IrisYzh/SnapChef/Ideation/Fridge Ingredient Recognition Device.docx

Fridge Ingredient Recognition Device

1. Project vision

FridgeLens is a magnet-mounted, battery-powered device that attaches to a refrigerator door. When the user presses a button, the onboard camera captures the fridge interior and a TensorFlow Lite model running on the XIAO ESP32S3 classifies the ingredients present. An OLED screen then suggests a recipe based on what is currently available and flags any ingredients that are close to expiring. The device works fully offline with no external data transmission.

It is designed for people who cook at home regularly but often struggle to decide what to make, or forget about ingredients that sit in the fridge too long and go to waste. FridgeLens bridges the gap between "I have stuff in the fridge" and "I know what to cook tonight."

2. Design target

- Classification accuracy: at least 85% across all 5 classes on a held-out test set
- Inference latency: under 2 seconds from button press to OLED display
- Battery life: at least 8 hours of standby with 50 active captures/day on a 1000 mAh LiPo
- Model size: under 1 MB to fit within the ESP32S3 flash budget

3. Resource constraint

The ESP32S3 provides 8 MB flash and 512 KB SRAM. The model binary is budgeted at 1 MB; runtime inference is capped at 200 KB SRAM to leave room for the image buffer and OLED driver. Camera input will be downsampled to 96x96 grayscale. The camera module powers down between captures to meet the battery target.

4. Trade-off hypothesis

The main trade-off is model size vs. accuracy. A MobileNetV2 backbone quantized to INT8 at 96x96 input is expected to meet the accuracy target while staying within the memory budget. Three operating points will be tested, 96x96 INT8, 128x128 INT8, and 96x96 FP32, and results will be plotted to identify the best trade-off. The prediction is that INT8 quantization costs less than 3% accuracy while reducing model size by roughly 4x.

5. Dataset plan

5 classes reflecting common everyday fridge ingredients: eggs, carrots, leafy greens, tofu, and condiment bottles. 150 images per class will be self-captured inside a real fridge under varied lighting and partial occlusion, then augmented to roughly 600 per class. A public food image dataset will supplement self-collected data. Split: 70% train / 10% validation / 20% test. The test set is held out until final evaluation. Class balance will be verified before training.

6. Timeline

Week | Milestone
1–2 | Hardware setup; data collection begins
3 | Dataset complete; augmentation applied
4 | Baseline model trained (224x224 FP32)
5 | TFLite INT8 conversion; first on-device inference
6 | Full pipeline integrated (button, camera, inference, OLED)
7 | Recipe matching and expiry reminder logic added
8 | Systematic evaluation: accuracy, latency, battery
9 | Enclosure built; UI polished
10 | Final report and demo submission

7. Risks

- Fridge lighting variability. Low or inconsistent light is the most likely failure mode. Mitigation: collect training data under low-light conditions and add a small fill LED to the enclosure.
- RAM overflow at inference time. If the model exceeds the memory budget, fall back to MobileNetV1 or reduce input to 64x64. Memory profiling will happen in Week 5 before full hardware integration.
