IrisYzh/SnapChef/image/receipt.png

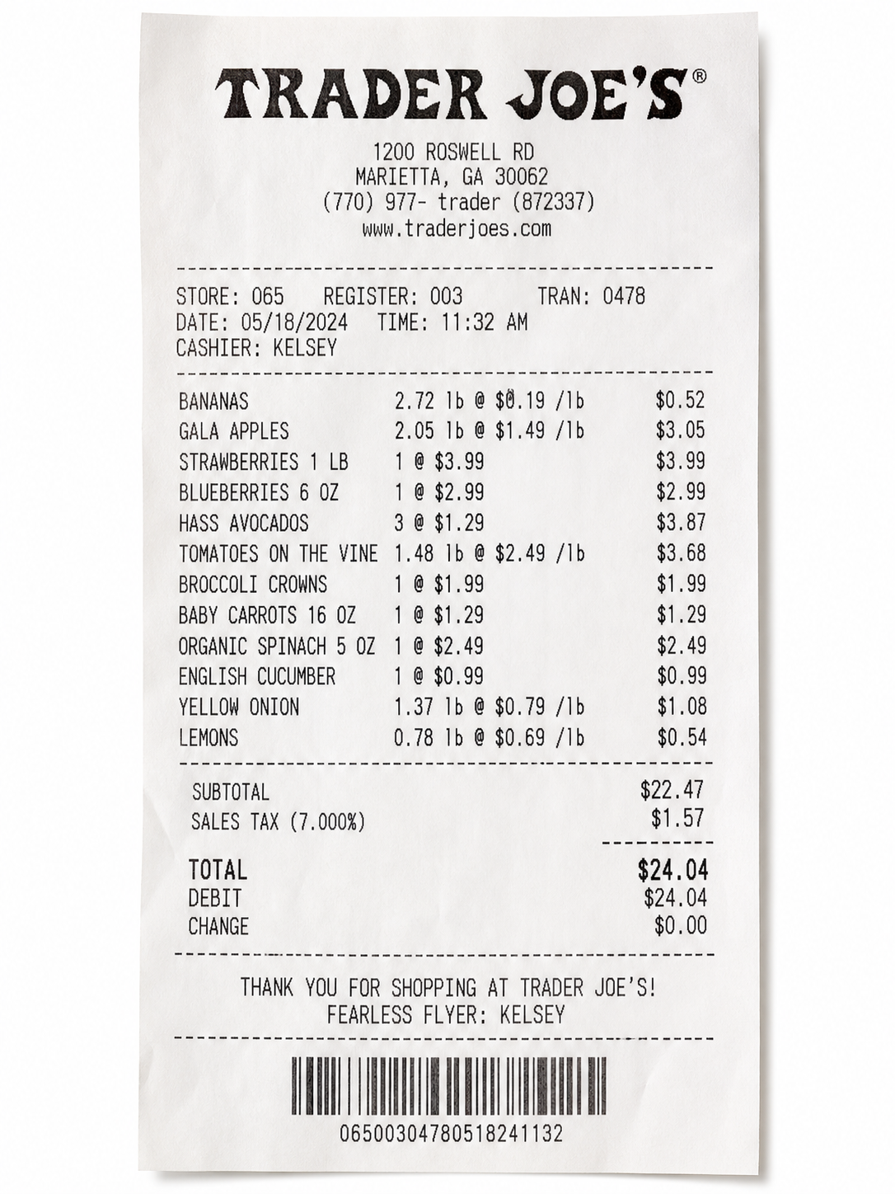
image/receipt.png
