IrisYzh/SnapChef/image/Workflow.png

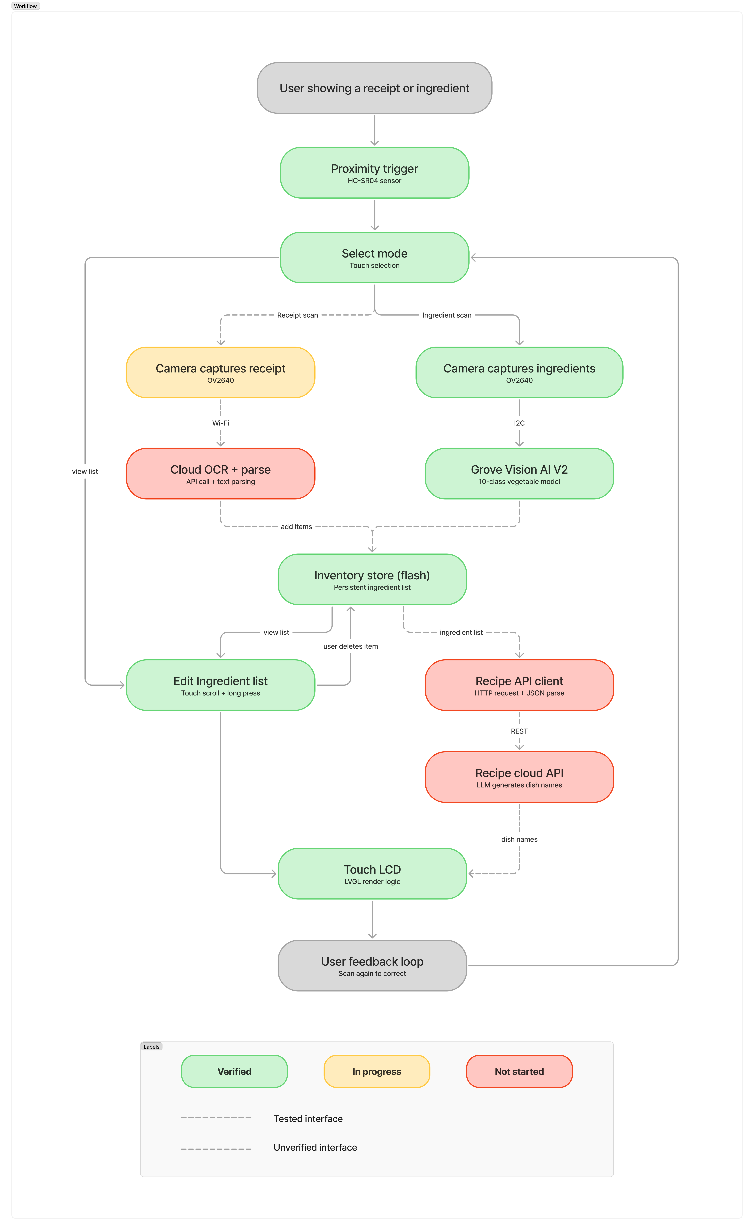
image/Workflow.png
