IrisYzh/SnapChef/HWSW Team Final Enclosure.step

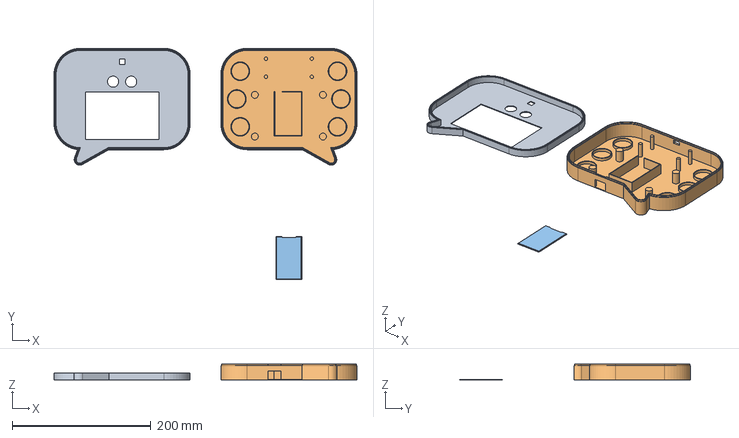
[picture p44: CAD file, 2026-06-10]
HWSW Team Final Enclosure.step
436.0 x 333.0 x 23.0 mm
