IrisYzh/SnapChef/src/main/main.ino

/*
 * SnapChef — Main controller (XIAO ESP32S3 Sense)
 *
 * Hosts the camera, HC-SR04 ultrasonic, WiFi, and an ESP-NOW peer link to
 * the display device (Waveshare 4.3" Touch LCD). This firmware is "headless"
 * — all UI lives on the display board, which talks to us over ESP-NOW.
 *
 * Capabilities exposed over ESP-NOW (tag 'E' / 'D' events, tag 'C' commands):
 *   1. Idle proximity wake — emits {"evt":"proximity_wake"} when an object
 *      is detected within ~10 cm of the HC-SR04.
 *   2. Veggie classification — on {"cmd":"start_veggie_scan"} runs the
 *      MobileNetV2 INT8 classifier (128x128, V4 weights) lifted from esp32_deploy_V7.
 *      Locks on >=80% top-1 confidence over 3 consecutive frames; gives up
 *      after 20 s.
 *   3. Receipt scan — on {"cmd":"capture_receipt"} switches the camera to
 *      UXGA, captures a single JPEG, POSTs it to /receipts/analyze, and
 *      streams the parsed items back as individual 'E' events.
 *   4. Recipe lookup — on {"cmd":"get_recipe","ingredients":[...]} returns a
 *      hard-coded mock recipe (Carrot/Eggplant/generic) — backend not built.
 *
 * Wiring (XIAO ESP32S3 Sense):
 *   HC-SR04: VCC -> 5V, GND -> GND, TRIG -> GPIO2, ECHO -> GPIO1
 *   Camera : FFC connector (OV2640 / OV3660)
 *
 * Arduino IDE setup:
 *   - Board: "XIAO_ESP32S3"
 *   - PSRAM: "OPI PSRAM"
 *   - Partition scheme: "Huge APP (3MB No OTA/1MB SPIFFS)"
 *
 * Required libraries:
 *   - TensorFlowLite_ESP32
 *   - WiFi / WiFiClientSecure / HTTPClient / esp_now (built in)
 */

#include <Arduino.h>
#include <vector>

#include <esp_camera.h>
#include <esp_heap_caps.h>
#include <mbedtls/base64.h>

#include <WiFi.h>
#include <WiFiClientSecure.h>
#include <HTTPClient.h>
#include <WebServer.h>

#include <esp_now.h>
#include <esp_wifi.h>
#include <time.h>

#include "tensorflow/lite/micro/micro_interpreter.h"
#include "tensorflow/lite/micro/micro_mutable_op_resolver.h"
#include "tensorflow/lite/schema/schema_generated.h"

#include "model_data.h"
#include "labels.h"
#include "snapchef_espnow.h"

// ============================================================================
//                                  CONFIG
// ============================================================================

// --- WiFi (UW MPSK; same credentials as receipt_read.ino) ---
static const char* WIFI_SSID = "UW MPSK";
static const char* WIFI_PASS = "5gwXiwWSng3EXHq5";

// --- Backend ---
static const char* API_URL     = "https://snapchef-backend-production.up.railway.app/receipts/analyze";
// Produce recognition uses the Claude-Vision endpoint (recognize-llm) rather
// than the Baidu one (recognize): same request/response shape, but far more
// robust on hand-held / plastic / poorly-framed shots where Baidu returns
// Uncertain. Request/response contract is identical, so the parsing below is
// unchanged (raw_name is always null on this endpoint).
static const char* PRODUCE_URL = "https://snapchef-backend-production.up.railway.app/produce/recognize-llm";
static const char* HEALTHZ_URL = "https://snapchef-backend-production.up.railway.app/healthz";
// Recipe endpoints (Claude-backed on the backend; change BASE_URL if you move
// these to a different host). Same X-API-Key as receipts.
static const char* RECIPES_LIST_URL  = "https://snapchef-backend-production.up.railway.app/recipes/list";
static const char* RECIPES_STEPS_URL = "https://snapchef-backend-production.up.railway.app/recipes/steps";
static const char* API_KEY     = "snapchefasdfghjkl123456789";
static const char* BOUNDARY    = "----snapchef32boundary";
static const int   HTTP_TIMEOUT_MS = 20000;
static const int   RECIPE_HTTP_TIMEOUT_MS = 30000;   // LLM generation can be slow

// --- HC-SR04 ---
static const int   TRIG_PIN     = 2;
static const int   ECHO_PIN     = 1;
static const float DETECT_CM    = 10.0f;
static const unsigned long PROXIMITY_INTERVAL_MS = 200;
static const unsigned long PROXIMITY_COOLDOWN_MS = 3000;

// --- Veggie classifier (mirrors esp32_deploy_V6.ino) ---
static const unsigned long INFERENCE_INTERVAL_MS = 500;
// On-device scan window. If nothing locks in this time we fall back to the
// cloud /produce/recognize endpoint, which has its own HTTP_TIMEOUT_MS budget.
static const unsigned long VEGGIE_LOCAL_TIMEOUT_MS = 5000;
static const int  IMG_W = 128, IMG_H = 128, IMG_C = 3;     // V4 model: 128x128
static const int  TENSOR_ARENA_SIZE = 700 * 1024;          // ~(128/96)^2 of V3's 512KB
static const float CONF_LOCK = 0.90f;
static const int   LOCK_STREAK_NEEDED    = 3;
static const int   RELEASE_STREAK_NEEDED = 3;
// Highest-fidelity JPEG quality (lower = better) used for both full-res
// captures — receipt OCR and cloud produce recognition. The camera DMA/JPEG
// buffer is sized at init for this value, so the runtime up-shift to it never
// overflows (see initCamera + captureJpegUXGA). Don't push below ~6 without
// re-checking PSRAM headroom and the backend's ~3 MB raw-image cap.
static const int   CAPTURE_JPEG_QUALITY = 6;

// --- Camera pins (XIAO ESP32S3 Sense FFC) ---
#define PWDN_GPIO_NUM   -1
#define RESET_GPIO_NUM  -1
#define XCLK_GPIO_NUM   10
#define SIOD_GPIO_NUM   40
#define SIOC_GPIO_NUM   39
#define Y9_GPIO_NUM     48
#define Y8_GPIO_NUM     11
#define Y7_GPIO_NUM     12
#define Y6_GPIO_NUM     14
#define Y5_GPIO_NUM     16
#define Y4_GPIO_NUM     18
#define Y3_GPIO_NUM     17
#define Y2_GPIO_NUM     15
#define VSYNC_GPIO_NUM  38
#define HREF_GPIO_NUM   47
#define PCLK_GPIO_NUM   13

// QVGA RGB888 buffer used by the veggie pipeline.
static const int CAPTURE_W = 320;
static const int CAPTURE_H = 240;

// ============================================================================
//                              GLOBAL STATE
// ============================================================================

enum MainState {
    STATE_IDLE,
    STATE_VEGGIE_SCAN,
    STATE_RECEIPT_CAPTURE,
    STATE_RECEIPT_UPLOAD,
    STATE_RECIPE,
};

static volatile MainState gState = STATE_IDLE;
static volatile bool gCancelRequested = false;
static String  gPendingPurpose = "in";           // for veggie scan
static String  gPendingIngredientsJson = "[]";   // for recipe
static String  gPendingTrigger = "";             // for recipe list (just-removed item)
static String  gPendingDish    = "";             // for recipe steps (chosen dish)

// --- TFLM ---
static uint8_t* tensor_arena = nullptr;
static uint8_t* rgb888_buf   = nullptr;
static const tflite::Model*       tfl_model     = nullptr;
static tflite::MicroInterpreter*  interpreter   = nullptr;
static TfLiteTensor*              input_tensor  = nullptr;
static TfLiteTensor*              output_tensor = nullptr;
static float   input_scale = 0, output_scale = 0;
static int32_t input_zero_point = 0, output_zero_point = 0;
static int     unknown_class_idx = -1;

// --- Veggie smoothing ---
static int   current_display_idx  = -1;
static float current_display_conf = 0.0f;
static int   lock_candidate_idx   = -1;
static int   lock_streak          = 0;
static int   release_streak       = 0;

// --- ESP-NOW link to the display ---
static const uint8_t BROADCAST_MAC[6] = { 0xFF,0xFF,0xFF,0xFF,0xFF,0xFF };
static uint8_t       gPeerMac[6]      = {0};
static volatile bool gPeerLinked      = false;
static volatile bool gPeerJustLinked  = false;   // set on HELLO, drained in loop()

// --- Pending commands queue (filled in ESP-NOW recv callback, drained in loop()) ---
static volatile bool gCmdPending = false;
static String gPendingCmd;

// --- DEBUG: last captured receipt JPEG, served over HTTP for browser preview ---
static WebServer  gDebugServer(80);
static uint8_t*   gLastJpeg    = nullptr;
static size_t     gLastJpegLen = 0;
static uint32_t   gLastJpegSeq = 0;

// ============================================================================
//                              FORWARD DECLS
// ============================================================================

static bool initCamera();
static bool initModel();
static bool captureAndPreprocess(int8_t* dst);
static uint8_t* captureJpegUXGA(int jpegQuality, size_t& outLen);
static void resetSmoothing();
static void runVeggieScan();
static bool runCloudProduceFallback(const String& purpose);
static void runReceiptCapture();
static void runRecipe();
static void runRecipeList();
static void runRecipeSteps();
static void sendEvent(const String& json);
static void sendData(const String& payload);

// ============================================================================
//                               CAMERA
// ============================================================================

static bool initCamera() {
    camera_config_t config = {};
    config.ledc_channel = LEDC_CHANNEL_0;
    config.ledc_timer   = LEDC_TIMER_0;
    config.pin_d0       = Y2_GPIO_NUM;
    config.pin_d1       = Y3_GPIO_NUM;
    config.pin_d2       = Y4_GPIO_NUM;
    config.pin_d3       = Y5_GPIO_NUM;
    config.pin_d4       = Y6_GPIO_NUM;
    config.pin_d5       = Y7_GPIO_NUM;
    config.pin_d6       = Y8_GPIO_NUM;
    config.pin_d7       = Y9_GPIO_NUM;
    config.pin_xclk     = XCLK_GPIO_NUM;
    config.pin_pclk     = PCLK_GPIO_NUM;
    config.pin_vsync    = VSYNC_GPIO_NUM;
    config.pin_href     = HREF_GPIO_NUM;
    config.pin_sccb_sda = SIOD_GPIO_NUM;
    config.pin_sccb_scl = SIOC_GPIO_NUM;
    config.pin_pwdn     = PWDN_GPIO_NUM;
    config.pin_reset    = RESET_GPIO_NUM;
    config.xclk_freq_hz = 20000000;
    config.pixel_format = PIXFORMAT_JPEG;
    // Init at UXGA so the camera DMA buffer is sized for the largest capture
    // we'll ever do (receipt path). Sensor is immediately downshifted to QVGA
    // below for the veggie streaming path; runtime set_framesize() can then
    // safely upshift back to UXGA without FB-OVF.
    config.frame_size   = FRAMESIZE_UXGA;
    // Size the JPEG buffer for the highest-fidelity capture we'll ever take
    // (receipt + cloud produce both use CAPTURE_JPEG_QUALITY). Lower quality
    // numbers => larger frames; sizing for it here means a runtime
    // set_quality() to it can't overflow the buffer (FB-OVF). The veggie
    // streaming path uses a larger number (q10), which is smaller and safe.
    config.jpeg_quality = CAPTURE_JPEG_QUALITY;
    config.fb_count     = 2;
    config.fb_location  = CAMERA_FB_IN_PSRAM;
    config.grab_mode    = CAMERA_GRAB_LATEST;

    if (esp_camera_init(&config) != ESP_OK) return false;

    sensor_t* s = esp_camera_sensor_get();
    if (s && s->id.PID == OV3660_PID) {
        s->set_brightness(s, 1);
        s->set_saturation(s, -1);
        s->set_vflip(s, 1);
    }
    if (s) {
        s->set_whitebal(s, 1);
        s->set_awb_gain(s, 1);
        s->set_exposure_ctrl(s, 1);
        s->set_aec2(s, 1);
        s->set_gain_ctrl(s, 1);
        // DMA buffer is sized for UXGA above; drop the sensor down to QVGA for
        // veggie streaming. Receipt path will upshift back to UXGA on demand.
        s->set_framesize(s, FRAMESIZE_QVGA);
        s->set_quality(s, 10);
    }

    rgb888_buf = (uint8_t*)heap_caps_malloc(CAPTURE_W * CAPTURE_H * 3, MALLOC_CAP_SPIRAM);
    return rgb888_buf != nullptr;
}

// Drains stale frames from the queue — call after framesize/quality changes
// so the next esp_camera_fb_get() returns one at the new settings.
static void drainCameraFrames(int n) {
    for (int i = 0; i < n; i++) {
        camera_fb_t* fb = esp_camera_fb_get();
        if (fb) esp_camera_fb_return(fb);
        delay(60);
    }
}

// ============================================================================
//                                TFLM MODEL
// ============================================================================

static bool initModel() {
    tensor_arena = (uint8_t*)heap_caps_aligned_alloc(16, TENSOR_ARENA_SIZE, MALLOC_CAP_SPIRAM);
    if (!tensor_arena) return false;

    tfl_model = tflite::GetModel(model_data);
    if (tfl_model->version() != TFLITE_SCHEMA_VERSION) return false;

    static tflite::MicroMutableOpResolver<14> resolver;
    resolver.AddConv2D();
    resolver.AddDepthwiseConv2D();
    resolver.AddFullyConnected();
    resolver.AddAdd();
    resolver.AddPad();
    resolver.AddMean();
    resolver.AddReshape();
    resolver.AddSoftmax();
    resolver.AddMul();
    resolver.AddSub();
    resolver.AddQuantize();
    resolver.AddDequantize();
    resolver.AddLogistic();
    resolver.AddRelu6();

    static tflite::MicroInterpreter static_interpreter(
        tfl_model, resolver, tensor_arena, TENSOR_ARENA_SIZE);
    interpreter = &static_interpreter;
    if (interpreter->AllocateTensors() != kTfLiteOk) return false;

    input_tensor      = interpreter->input(0);
    output_tensor     = interpreter->output(0);
    input_scale       = input_tensor->params.scale;
    input_zero_point  = input_tensor->params.zero_point;
    output_scale      = output_tensor->params.scale;
    output_zero_point = output_tensor->params.zero_point;

    for (int i = 0; i < NUM_CLASSES; i++) {
        if (strcmp(LABELS[i], "Unknown") == 0) { unknown_class_idx = i; break; }
    }
    return true;
}

// ============================================================================
//                       VEGGIE: capture + preprocess + invoke
// ============================================================================

static bool captureAndPreprocess(int8_t* dst) {
    camera_fb_t* fb = esp_camera_fb_get();
    if (!fb) return false;
    if (fb->format != PIXFORMAT_JPEG ||
        !fmt2rgb888(fb->buf, fb->len, fb->format, rgb888_buf)) {
        esp_camera_fb_return(fb);
        return false;
    }
    const int src_w = fb->width;
    const int src_h = fb->height;
    esp_camera_fb_return(fb);

    // Center-crop to square, nearest-neighbour resize to IMG_W, INT8 quantise.
    const int crop  = src_w < src_h ? src_w : src_h;
    const int x_off = (src_w - crop) / 2;
    const int y_off = (src_h - crop) / 2;
    const float inv_scale = 1.0f / input_scale;

    for (int y = 0; y < IMG_H; y++) {
        const int sy = y_off + (y * crop) / IMG_H;
        for (int x = 0; x < IMG_W; x++) {
            const int sx = x_off + (x * crop) / IMG_W;
            const int pi = (sy * src_w + sx) * 3;
            const int idx = (y * IMG_W + x) * IMG_C;
            dst[idx + 0] = (int8_t)lroundf((float)rgb888_buf[pi + 0] * inv_scale + input_zero_point);
            dst[idx + 1] = (int8_t)lroundf((float)rgb888_buf[pi + 1] * inv_scale + input_zero_point);
            dst[idx + 2] = (int8_t)lroundf((float)rgb888_buf[pi + 2] * inv_scale + input_zero_point);
        }
    }
    return true;
}

static void resetSmoothing() {
    current_display_idx  = -1;
    current_display_conf = 0.0f;
    lock_candidate_idx   = -1;
    lock_streak          = 0;
    release_streak       = 0;
}

// Returns true if a class is currently locked (display-ready).
static bool classifyOnce(int& outIdx, float& outConf, bool& outLocked) {
    outLocked = false;
    if (!captureAndPreprocess(input_tensor->data.int8)) return false;
    if (interpreter->Invoke() != kTfLiteOk) return false;

    int8_t* q = output_tensor->data.int8;
    int   raw_idx = 0;
    int8_t raw_q  = q[0];
    for (int i = 1; i < NUM_CLASSES; i++) {
        if (q[i] > raw_q) { raw_q = q[i]; raw_idx = i; }
    }
    const float raw_max = (raw_q - output_zero_point) * output_scale;

    const bool is_unknown_class = (raw_idx == unknown_class_idx);
    const bool is_detection     = (raw_max >= CONF_LOCK) && !is_unknown_class;

    if (is_detection) {
        if (raw_idx == lock_candidate_idx) lock_streak++;
        else { lock_candidate_idx = raw_idx; lock_streak = 1; }

        if (raw_idx == current_display_idx) {
            release_streak = 0;
            current_display_conf = raw_max;
        } else {
            release_streak++;
        }

        if (lock_streak >= LOCK_STREAK_NEEDED && raw_idx != current_display_idx) {
            current_display_idx  = raw_idx;
            current_display_conf = raw_max;
            release_streak = 0;
        }
    } else {
        lock_candidate_idx = -1;
        lock_streak        = 0;
        if (current_display_idx != -1) {
            release_streak++;
            if (release_streak >= RELEASE_STREAK_NEEDED) {
                current_display_idx = -1;
                current_display_conf = 0.0f;
                release_streak = 0;
            }
        }
    }

    if (current_display_idx >= 0) {
        outIdx    = current_display_idx;
        outConf   = current_display_conf;
        outLocked = true;
    } else {
        outIdx  = raw_idx;
        outConf = raw_max;
    }
    return true;
}

// ============================================================================
//                                   WiFi
// ============================================================================

static bool connectWiFi() {
    if (WiFi.status() == WL_CONNECTED) return true;
    WiFi.mode(WIFI_STA);
    delay(50);
    Serial.printf("[wifi] mac=%s connecting to %s\n",
                  WiFi.macAddress().c_str(), WIFI_SSID);
    WiFi.begin(WIFI_SSID, WIFI_PASS);
    unsigned long t0 = millis();
    while (WiFi.status() != WL_CONNECTED && millis() - t0 < 30000) {
        delay(400);
        Serial.print(".");
    }
    Serial.println();
    if (WiFi.status() != WL_CONNECTED) {
        Serial.println("[wifi] connect FAILED");
        return false;
    }
    Serial.printf("[wifi] connected ip=%s rssi=%d\n",
                  WiFi.localIP().toString().c_str(), WiFi.RSSI());
    return true;
}

// We share one radio with the Wi-Fi STA, so while associated the channel is
// dictated by the AP (often not the display's). The display sits on ONE channel
// chosen at its boot — we don't know which — so main scans these candidates
// (in loop(), while unlinked) and LOCKS to whichever one the display's HELLO
// arrives on (see onEspNowRecv). No guessing. parkEspnow() then keeps the radio
// on that locked channel between transient Wi-Fi calls. Trade-off: no always-on
// Wi-Fi (the debug preview server is only reachable mid-upload).
static const uint8_t kEspnowHopChans[] = {1, 6, 11};
static int  gEspnowChannel = 11;     // locked channel once the display is found
static int  gCurChan       = 11;     // channel the radio is on right now
static int  gHopIdx        = 0;
static unsigned long gLastHopMs = 0;

static void parkEspnow() {
    WiFi.disconnect(false);        // deassociate but keep STA up for ESP-NOW
    delay(30);
    esp_wifi_set_channel(gEspnowChannel, WIFI_SECOND_CHAN_NONE);
    gCurChan = gEspnowChannel;
    Serial.printf("[espnow] parked on channel %d\n", gEspnowChannel);
}

// ============================================================================
//                       DEBUG: receipt preview HTTP server
// ============================================================================

// Replaces gLastJpeg with a fresh copy of the JPEG bytes. Safe to call from
// the same task that runs the camera (no concurrent reader in this firmware
// other than gDebugServer.handleClient() in loop()).
static void debugStoreReceiptJpeg(const uint8_t* jpeg, size_t len) {
    if (gLastJpeg) { heap_caps_free(gLastJpeg); gLastJpeg = nullptr; gLastJpegLen = 0; }
    uint8_t* buf = (uint8_t*)heap_caps_malloc(len, MALLOC_CAP_SPIRAM);
    if (!buf) { Serial.println("[debug] PSRAM alloc for preview JPEG failed"); return; }
    memcpy(buf, jpeg, len);
    gLastJpeg    = buf;
    gLastJpegLen = len;
    gLastJpegSeq++;
    Serial.printf("[debug] preview JPEG ready, %u bytes — http://%s/\n",
                  (unsigned)len, WiFi.localIP().toString().c_str());
}

static void debugServerHandleIndex() {
    String html = "<!doctype html><meta charset=utf-8><title>SnapChef receipt</title>";
    html += "<style>body{font-family:sans-serif;margin:16px;background:#111;color:#eee}"
            "img{max-width:100%;border:1px solid #444}</style>";
    html += "<h2>Last captured receipt</h2>";
    if (gLastJpegLen == 0) {
        html += "<p>No receipt captured yet. Trigger a receipt scan from the display.</p>";
    } else {
        html += "<p>" + String((unsigned)gLastJpegLen) + " bytes, seq " + String(gLastJpegSeq) + "</p>";
        html += "<img src=\"/last.jpg?seq=" + String(gLastJpegSeq) + "\">";
        html += "<script>setTimeout(()=>location.reload(), 3000)</script>";
    }
    gDebugServer.send(200, "text/html; charset=utf-8", html);
}

static void debugServerHandleJpeg() {
    if (gLastJpegLen == 0 || !gLastJpeg) {
        gDebugServer.send(404, "text/plain", "no jpeg yet");
        return;
    }
    gDebugServer.sendHeader("Cache-Control", "no-store");
    gDebugServer.send_P(200, "image/jpeg", (const char*)gLastJpeg, gLastJpegLen);
}

static void initDebugServer() {
    gDebugServer.on("/",         debugServerHandleIndex);
    gDebugServer.on("/last.jpg", debugServerHandleJpeg);
    gDebugServer.begin();
    Serial.printf("[debug] preview server on http://%s/\n",
                  WiFi.localIP().toString().c_str());
}

static void healthzSelfCheck() {
    WiFiClientSecure client;
    client.setInsecure();
    HTTPClient http;
    http.setTimeout(5000);
    if (!http.begin(client, HEALTHZ_URL)) return;
    int code = http.GET();
    Serial.printf("[wifi] healthz %d %s\n", code, http.getString().c_str());
    http.end();
}

// ============================================================================
//                              IMAGE UPLOAD
// ============================================================================

// Shared multipart/form-data JPEG upload. Builds a single `image` field POST,
// returns the full HTTP response body (raw JSON) on 200, empty string on err.
// On error also fills `errCode` / `errMsg` for an event payload. `tag` is just a
// serial-log prefix; `filename` is the multipart filename.
static String uploadImageMultipart(const char* url, const char* filename,
                                   const char* tag,
                                   const uint8_t* jpeg, size_t jpeg_len,
                                   String& errCode, String& errMsg) {
    errCode = ""; errMsg = "";
    if (!connectWiFi()) {
        errCode = "wifi"; errMsg = "WiFi unavailable";
        return "";
    }

    String prefix = String("--") + BOUNDARY + "\r\n"
                    "Content-Disposition: form-data; name=\"image\"; filename=\"" + filename + "\"\r\n"
                    "Content-Type: image/jpeg\r\n\r\n";
    String suffix = String("\r\n--") + BOUNDARY + "--\r\n";
    size_t total = prefix.length() + jpeg_len + suffix.length();
    uint8_t* body = (uint8_t*)heap_caps_malloc(total, MALLOC_CAP_SPIRAM);
    if (!body) {
        errCode = "oom"; errMsg = "PSRAM alloc failed";
        return "";
    }
    memcpy(body, prefix.c_str(), prefix.length());
    memcpy(body + prefix.length(), jpeg, jpeg_len);
    memcpy(body + prefix.length() + jpeg_len, suffix.c_str(), suffix.length());

    WiFiClientSecure client;
    client.setInsecure();
    HTTPClient http;
    http.setTimeout(HTTP_TIMEOUT_MS);
    if (!http.begin(client, url)) {
        free(body);
        errCode = "http_begin"; errMsg = "begin() failed";
        return "";
    }
    http.addHeader("Content-Type", String("multipart/form-data; boundary=") + BOUNDARY);
    http.addHeader("X-API-Key", API_KEY);

    unsigned long t0 = millis();
    int code = http.POST(body, total);
    unsigned long dt = millis() - t0;
    String resp = http.getString();
    http.end();
    free(body);

    Serial.printf("[%s] HTTP %d in %lu ms, %u bytes\n",
                  tag, code, dt, (unsigned)resp.length());
    Serial.printf("[%s] body: %s\n", tag, resp.c_str());
    if (code != 200) {
        errCode = "http_" + String(code);
        errMsg  = resp.length() ? resp : "HTTP error";
        return "";
    }
    return resp;
}

// Returns the full HTTP response body (raw JSON) on 200, empty string on err.
// On error also fills `errCode` / `errMsg` for an event payload.
static String uploadReceipt(const uint8_t* jpeg, size_t jpeg_len,
                            String& errCode, String& errMsg) {
    return uploadImageMultipart(API_URL, "receipt.jpg", "receipt",
                                jpeg, jpeg_len, errCode, errMsg);
}

// Uploads a single produce JPEG to /produce/recognize. Same contract as
// uploadReceipt; the response is {name, raw_name, confidence}.
static String uploadProduce(const uint8_t* jpeg, size_t jpeg_len,
                            String& errCode, String& errMsg) {
    return uploadImageMultipart(PRODUCE_URL, "produce.jpg", "produce",
                                jpeg, jpeg_len, errCode, errMsg);
}

// ============================================================================
//                                   RECIPE
// ============================================================================

// Hard-coded mocks until the backend lands. Returns full JSON.
// `ingredientsJson` is the raw JSON array string from the command, e.g.
//   ["Carrot","Tomato","Onion"]
static String buildRecipeMock(const String& ingredientsJson) {
    bool hasCarrot   = ingredientsJson.indexOf("\"Carrot\"")   >= 0;
    bool hasEggplant = ingredientsJson.indexOf("\"Eggplant\"") >= 0;

    String title;
    String steps;   // JSON array body, no surrounding brackets
    int    timeMin = 20;

    if (hasCarrot) {
        title = "Honey Glazed Carrots";
        timeMin = 20;
        steps = "\"Peel and slice carrots into 1\\/2-inch coins.\","
                "\"Saute in butter over medium heat for 6 min until tender.\","
                "\"Stir in 2 tbsp honey, a pinch of salt, finish with parsley.\"";
    } else if (hasEggplant) {
        title = "Eggplant Parmesan";
        timeMin = 35;
        steps = "\"Slice eggplant 1\\/4-inch thick; salt and rest 10 min.\","
                "\"Pan-fry slices in olive oil until golden on both sides.\","
                "\"Layer with marinara and mozzarella; bake 18 min at 200C.\"";
    } else {
        title = "Stir-Fried Vegetable Medley";
        timeMin = 15;
        steps = "\"Chop everything you took out into thumb-sized pieces.\","
                "\"Hot wok, oil, garlic 10s, harder veg first 2 min, soft veg 1 min.\","
                "\"Splash soy sauce + sesame oil, toss, plate.\"";
    }

    String json = "{";
    json += "\"evt\":\"recipe_result\",";
    json += "\"title\":\""  + title + "\",";
    json += "\"time_min\":" + String(timeMin) + ",";
    json += "\"steps\":[" + steps + "],";
    json += "\"ingredients\":" + ingredientsJson;
    json += "}";
    return json;
}

// Generic HTTPS JSON POST. Returns the response body on 200, empty on err.
// On error, fills errCode/errMsg for a payload back to the display.
static String httpPostJson(const char* url, const String& body,
                            int timeout_ms, String& errCode, String& errMsg) {
    errCode = ""; errMsg = "";
    if (!connectWiFi()) { errCode = "wifi"; errMsg = "WiFi unavailable"; return ""; }

    WiFiClientSecure client;
    client.setInsecure();
    HTTPClient http;
    http.setTimeout(timeout_ms);
    if (!http.begin(client, url)) { errCode = "http_begin"; errMsg = "begin() failed"; return ""; }
    http.addHeader("Content-Type", "application/json");
    http.addHeader("X-API-Key", API_KEY);

    unsigned long t0 = millis();
    int code = http.POST((uint8_t*)body.c_str(), body.length());
    unsigned long dt = millis() - t0;
    String resp = http.getString();
    http.end();

    Serial.printf("[http] POST %s -> %d in %lu ms (%u bytes)\n",
                  url, code, dt, (unsigned)resp.length());
    if (code != 200) {
        errCode = "http_" + String(code);
        errMsg  = resp.length() ? resp : "HTTP error";
        return "";
    }
    return resp;
}

// Trim wrapping whitespace/quotes from a dish name.
static String trimQuoted(const String& s) {
    int a = 0, b = (int)s.length();
    while (a < b && (s[a] == ' ' || s[a] == '\t')) a++;
    while (b > a && (s[b-1] == ' ' || s[b-1] == '\t')) b--;
    return s.substring(a, b);
}

// Pull a string array out of {"dishes":["A","B","C"]} into a pipe-joined
// "A|B|C". Tolerant — uses simple scanning so we don't need a JSON lib.
static String dishesFromJson(const String& json) {
    String pat = "\"dishes\":[";
    int i = json.indexOf(pat); if (i < 0) return "";
    i += pat.length();
    int end = json.indexOf(']', i); if (end < 0) end = json.length();
    String out;
    while (i < end) {
        int q1 = json.indexOf('"', i); if (q1 < 0 || q1 >= end) break;
        int q2 = json.indexOf('"', q1 + 1); if (q2 < 0 || q2 > end) break;
        String name = trimQuoted(json.substring(q1 + 1, q2));
        if (name.length()) { if (out.length()) out += '|'; out += name; }
        i = q2 + 1;
    }
    return out;
}

// POST to /recipes/list — backend should return {"dishes":["A","B","C"]}.
// We forward dishes as a pipe-joined list inside a small JSON envelope so
// the display can splice them straight into populateTakeOutRecipes().
static void runRecipeList() {
    gState = STATE_RECIPE;
    Serial.printf("[recipe_list] trigger=%s fridge=%s\n",
                  gPendingTrigger.c_str(), gPendingIngredientsJson.c_str());

    String body = "{\"trigger\":\"";
    body += gPendingTrigger;
    body += "\",\"fridge\":";
    body += gPendingIngredientsJson;
    body += "}";

    String errCode, errMsg;
    String resp = httpPostJson(RECIPES_LIST_URL, body, RECIPE_HTTP_TIMEOUT_MS,
                                errCode, errMsg);

    String dishes;
    if (resp.length()) dishes = dishesFromJson(resp);

    if (!dishes.length()) {
        // Fall back to a tiny mock so the UI still has something to show
        // when the backend isn't ready / call failed.
        Serial.printf("[recipe_list] fallback (err=%s)\n", errCode.c_str());
        if (gPendingTrigger.indexOf("Carrot") >= 0)
            dishes = "Honey Glazed Carrots|Carrot Soup|Roasted Carrots";
        else if (gPendingTrigger.indexOf("Tomato") >= 0)
            dishes = "Caprese Salad|Tomato Omelette|Pasta Pomodoro";
        else if (gPendingTrigger.indexOf("Eggplant") >= 0)
            dishes = "Eggplant Parmesan|Baba Ganoush|Ratatouille";
        else
            dishes = "Stir-Fried Medley|Quick Soup|Veggie Wrap";
    }

    parkEspnow();   // back to the display's channel before ESP-NOW sends
    String payload = "{\"evt\":\"recipe_list\",\"dishes\":\"";
    payload += dishes;
    payload += "\"}";
    sendEvent("{\"evt\":\"recipe_list\"}");
    sendData(payload);
    gState = STATE_IDLE;
}

// POST to /recipes/steps — backend should return
//   {"title":"...","time_min":15,"steps":["...","..."]}.
// We add the evt envelope and forward to the display.
static void runRecipeSteps() {
    gState = STATE_RECIPE;
    Serial.printf("[recipe_steps] dish=%s fridge=%s\n",
                  gPendingDish.c_str(), gPendingIngredientsJson.c_str());

    String body = "{\"dish\":\"";
    body += gPendingDish;
    body += "\",\"fridge\":";
    body += gPendingIngredientsJson;
    body += "}";

    String errCode, errMsg;
    String resp = httpPostJson(RECIPES_STEPS_URL, body, RECIPE_HTTP_TIMEOUT_MS,
                                errCode, errMsg);

    String payload;
    if (resp.length()) {
        // Backend returns body without evt envelope; splice one in.
        // The response starts with '{'; insert "evt":"recipe_result", right after.
        int brace = resp.indexOf('{');
        if (brace >= 0) {
            payload  = resp.substring(0, brace + 1);
            payload += "\"evt\":\"recipe_result\",";
            payload += resp.substring(brace + 1);
        }
    }
    if (payload.length() == 0) {
        // Fall back to the existing mock-builder when the API fails so the
        // UI still gets a recipe.
        Serial.printf("[recipe_steps] fallback (err=%s)\n", errCode.c_str());
        payload = buildRecipeMock(gPendingIngredientsJson);
    }

    parkEspnow();   // back to the display's channel before ESP-NOW sends
    sendEvent("{\"evt\":\"recipe_result\"}");
    sendData(payload);
    gState = STATE_IDLE;
}

// ============================================================================
//                                  HC-SR04
// ============================================================================

static float readDistanceCm() {
    digitalWrite(TRIG_PIN, LOW);
    delayMicroseconds(2);
    digitalWrite(TRIG_PIN, HIGH);
    delayMicroseconds(10);
    digitalWrite(TRIG_PIN, LOW);
    long dur = pulseIn(ECHO_PIN, HIGH, 30000);  // 30 ms timeout (~5 m)
    if (dur == 0) return 999.0f;
    return dur * 0.0343f / 2.0f;
}

// ============================================================================
//                              ESP-NOW: helpers
// ============================================================================

static bool addPeer(const uint8_t* mac) {
    if (esp_now_is_peer_exist(mac)) return true;
    esp_now_peer_info_t p = {};
    memcpy(p.peer_addr, mac, 6);
    p.channel = 0;            // 0 = use the current STA channel
    p.ifidx   = WIFI_IF_STA;
    p.encrypt = false;
    esp_err_t err = esp_now_add_peer(&p);
    if (err != ESP_OK) {
        Serial.printf("[espnow] add_peer failed: %d\n", err);
        return false;
    }
    return true;
}

static void espnowSendRaw(const uint8_t* mac, const uint8_t* buf, size_t len) {
    esp_err_t err = esp_now_send(mac, buf, len);
    if (err != ESP_OK) Serial.printf("[espnow] send err: %d\n", err);
}

static void sendEvent(const String& json) {
    if (!gPeerLinked) return;
    // Tag byte + JSON body. Events are kept short by design (well under the
    // 250 B ESP-NOW ceiling), so single-frame transmission is fine.
    std::vector<uint8_t> buf(json.length() + 1);
    buf[0] = SNAPCHEF_MSG_EVT;
    memcpy(buf.data() + 1, json.c_str(), json.length());
    espnowSendRaw(gPeerMac, buf.data(), buf.size());
    Serial.printf("[espnow:evt] %s\n", json.c_str());
}

// Relays the current wall-clock (UTC epoch) to the display, which has no clock
// or internet of its own. No-op until NTP has set our clock. The display uses
// this to stamp inventory add-times. Call from loop() (not the recv callback).
static void sendTimeSync() {
    time_t t = time(nullptr);
    if (t < 1700000000) return;            // clock not synced yet (~2023-11)
    if (!gPeerLinked) return;
    sendEvent(String("{\"evt\":\"time_sync\",\"epoch\":") + String((uint32_t)t) + "}");
}

// Splits `payload` (raw text, typically JSON) into framed chunks of the form
//   "<seq>/<total>|<frag>"
// and sends each as one tagged ESP-NOW frame. Display reassembles by parsing
// the header.
static void sendData(const String& payload) {
    if (!gPeerLinked) return;
    const int frag = SNAPCHEF_DATA_FRAG_MAX;
    int total = (payload.length() + frag - 1) / frag;
    if (total == 0) total = 1;
    Serial.printf("[espnow:data] sending %d bytes in %d frames\n",
                  (int)payload.length(), total);
    for (int i = 0; i < total; i++) {
        String chunk;
        chunk.reserve(frag + 16);
        chunk += String(i + 1);
        chunk += '/';
        chunk += String(total);
        chunk += '|';
        chunk += payload.substring(i * frag,
                                    min((int)payload.length(), (i + 1) * frag));
        std::vector<uint8_t> buf(chunk.length() + 1);
        buf[0] = SNAPCHEF_MSG_DATA;
        memcpy(buf.data() + 1, chunk.c_str(), chunk.length());
        espnowSendRaw(gPeerMac, buf.data(), buf.size());
        delay(20);   // pace consecutive sends so the WiFi TX queue can drain
    }
}

// ============================================================================
//                          ESP-NOW: receive callback + init
// ============================================================================

static void onEspNowRecv(const esp_now_recv_info_t* info,
                         const uint8_t* data, int len) {
    if (len < 1) return;
    char tag = (char)data[0];
    const uint8_t* mac = info->src_addr;

    if (tag == SNAPCHEF_MSG_HELLO) {
        // Display has appeared on the channel we're currently scanning — lock
        // to it, bind it as our unicast peer, and ACK with READY.
        memcpy(gPeerMac, mac, 6);
        addPeer(gPeerMac);
        gPeerLinked = true;
        gPeerJustLinked = true;   // loop() will push a time_sync to the new peer
        gEspnowChannel = gCurChan;
        Serial.printf("[espnow] peer linked %02X:%02X:%02X:%02X:%02X:%02X on channel %d\n",
                      mac[0],mac[1],mac[2],mac[3],mac[4],mac[5], gCurChan);
        uint8_t ready = SNAPCHEF_MSG_READY;
        espnowSendRaw(gPeerMac, &ready, 1);
        return;
    }

    if (tag == SNAPCHEF_MSG_CMD) {
        String s; s.reserve(len);
        for (int i = 1; i < len; i++) s += (char)data[i];
        Serial.printf("[espnow:cmd] %s\n", s.c_str());
        // Re-bind peer in case display restarted with a new MAC.
        if (!gPeerLinked || memcmp(mac, gPeerMac, 6) != 0) {
            memcpy(gPeerMac, mac, 6);
            addPeer(gPeerMac);
            gPeerLinked = true;
            gEspnowChannel = gCurChan;
        }
        // Cancel is handled inline; everything else queued for the main loop.
        if (s.indexOf("\"cancel\"") >= 0) {
            gCancelRequested = true;
            return;
        }
        gPendingCmd = s;
        gCmdPending = true;
        return;
    }
}

static void initEspNow() {
    // WiFi STA mode is required for ESP-NOW; main has already attempted
    // WiFi.begin() in setup(), which puts us in STA. The ESP-NOW socket
    // inherits the current STA channel — if WiFi connect failed we end up
    // on whatever channel the radio defaulted to (typically 1), and the
    // display's SSID-scan discovery falls back to channel 1 to match.
    if (esp_now_init() != ESP_OK) {
        Serial.println("[espnow] init failed");
        return;
    }
    esp_now_register_recv_cb(onEspNowRecv);
    addPeer(BROADCAST_MAC);    // so broadcast sends are also legal

    uint8_t mac[6];
    WiFi.macAddress(mac);
    Serial.printf("[espnow] ready, mac=%02X:%02X:%02X:%02X:%02X:%02X chan=%d\n",
                  mac[0],mac[1],mac[2],mac[3],mac[4],mac[5], WiFi.channel());
}

// ============================================================================
//                            COMMAND HANDLERS
// ============================================================================

// Tiny purpose-built JSON helpers to avoid pulling in ArduinoJson.
// They assume the message comes from our own display firmware (well-formed).
static String extractStringField(const String& json, const char* key) {
    String pat = String("\"") + key + "\":\"";
    int i = json.indexOf(pat);
    if (i < 0) return "";
    i += pat.length();
    int j = json.indexOf('"', i);
    if (j < 0) return "";
    return json.substring(i, j);
}

// Returns "true" or "false" as a string (ready to splice into an outgoing
// JSON payload). Defaults to "false" when the key is missing.
static String extractBoolField(const String& json, const char* key) {
    String pat = String("\"") + key + "\":";
    int i = json.indexOf(pat);
    if (i < 0) return "false";
    i += pat.length();
    while (i < (int)json.length() && (json[i] == ' ' || json[i] == '\t')) i++;
    if (json.substring(i, i + 4) == "true") return "true";
    return "false";
}

// Parses a numeric field (e.g. "confidence":0.98). Returns `dflt` when the key
// is missing or its value is `null` — matches the /produce/recognize contract
// where confidence is null on an Uncertain result.
static float extractNumberField(const String& json, const char* key, float dflt) {
    String pat = String("\"") + key + "\":";
    int i = json.indexOf(pat);
    if (i < 0) return dflt;
    i += pat.length();
    while (i < (int)json.length() && (json[i] == ' ' || json[i] == '\t')) i++;
    if (json.substring(i, i + 4) == "null") return dflt;
    return json.substring(i).toFloat();
}

// Walks "items":[...] in a receipt response and streams the first `maxItems`
// out as one single-frame ESP-NOW event each:
//   {"evt":"receipt_item","idx":k,"total":N,"name":"…","needs_refrigeration":bool}
// Each event fits well under the 250-byte ESP-NOW frame ceiling, so this path
// avoids the chunked-data reassembler entirely. Returns the number of items
// emitted.
static int sendReceiptTestStream(const String& resp, int maxItems) {
    int items_pos = resp.indexOf("\"items\":[");
    if (items_pos < 0) return 0;

    // Pass 1: extract item ranges so we know `total` before emitting any event.
    std::vector<int> starts, ends;
    int p = items_pos + 9;
    int depth = 0;
    int item_start = -1;
    while (p < (int)resp.length() && (int)starts.size() < maxItems) {
        char c = resp[p];
        if (c == '{') {
            if (depth == 0) item_start = p;
            depth++;
        } else if (c == '}') {
            depth--;
            if (depth == 0 && item_start >= 0) {
                starts.push_back(item_start);
                ends.push_back(p + 1);
                item_start = -1;
            }
        } else if (c == ']' && depth == 0) {
            break;
        }
        p++;
    }

    int total = (int)starts.size();

    // Always emit a "begin" frame first so the display can switch to the
    // receipt-result screen and clear stale rows even when total == 0
    // (empty items array — Textract OK but no products parsed).
    {
        String j = "{\"evt\":\"receipt_test_begin\",\"total\":";
        j += String(total);
        j += "}";
        sendEvent(j);
        delay(80);
    }

    for (int i = 0; i < total; i++) {
        String item   = resp.substring(starts[i], ends[i]);
        String name   = extractStringField(item, "name");
        // Canonical produce name from the backend vocab; empty for non-produce
        // or unrecognized items. The display stores this in inventory when set.
        String norm   = extractStringField(item, "normalized_name");
        String refrig = extractBoolField(item, "needs_refrigeration");
        auto jsonEscape = [](const String& in) {
            String out; out.reserve(in.length() + 4);
            for (size_t k = 0; k < in.length(); k++) {
                char ch = in[k];
                if (ch == '"' || ch == '\\') out += '\\';
                out += ch;
            }
            return out;
        };
        String j = "{\"evt\":\"receipt_item\",\"idx\":";
        j += String(i);
        j += ",\"total\":";
        j += String(total);
        j += ",\"name\":\"";
        j += jsonEscape(name);
        j += "\",\"normalized_name\":\"";
        j += jsonEscape(norm);
        j += "\",\"needs_refrigeration\":";
        j += refrig;
        j += "}";
        sendEvent(j);
        delay(80);   // spacing so consecutive notifies don't overflow TX queue
    }
    return total;
}

static String extractArrayField(const String& json, const char* key) {
    String pat = String("\"") + key + "\":[";
    int i = json.indexOf(pat);
    if (i < 0) return "[]";
    i += pat.length() - 1;            // point at '['
    int depth = 0;
    for (int j = i; j < (int)json.length(); j++) {
        char c = json[j];
        if (c == '[') depth++;
        else if (c == ']') {
            depth--;
            if (depth == 0) return json.substring(i, j + 1);
        }
    }
    return "[]";
}

// Cloud fallback when the on-device classifier can't confirm: snap one
// max-quality JPEG, POST it to /produce/recognize, and emit a veggie_result on a
// confident hit. Returns true iff a veggie_result was sent; on any miss
// (Uncertain, HTTP/WiFi error, capture/oom) it returns false so the caller can
// fall through to veggie_unknown.
static bool runCloudProduceFallback(const String& purpose) {
    sendEvent(String("{\"evt\":\"veggie_cloud_lookup\",\"purpose\":\"") +
              purpose + "\"}");

    size_t   jlen = 0;
    uint8_t* jbuf = captureJpegUXGA(CAPTURE_JPEG_QUALITY, jlen);
    if (!jbuf) {
        Serial.println("[produce] capture failed");
        return false;
    }

    String errCode, errMsg;
    String resp = uploadProduce(jbuf, jlen, errCode, errMsg);
    heap_caps_free(jbuf);
    parkEspnow();   // back to the display's channel before any ESP-NOW send

    // Heavy WiFi/TLS just finished; let the radio settle before the next
    // ESP-NOW frame (sent by us on success, or by the caller's veggie_unknown
    // on failure), or it gets silently dropped (same as the receipt path).
    delay(500);

    if (resp.length() == 0) {
        Serial.printf("[produce] upload failed: %s %s\n",
                      errCode.c_str(), errMsg.c_str());
        return false;
    }

    String name = extractStringField(resp, "name");
    if (name.length() == 0 || name == "Uncertain") {
        Serial.printf("[produce] uncertain (name='%s')\n", name.c_str());
        return false;
    }
    float conf = extractNumberField(resp, "confidence", 0.0f);

    String j = "{";
    j += "\"evt\":\"veggie_result\",";
    j += "\"label\":\""; j += name; j += "\",";
    j += "\"confidence\":"; j += String(conf, 3); j += ",";
    j += "\"source\":\"cloud\",";
    j += "\"purpose\":\""; j += purpose; j += "\"";
    j += "}";
    sendEvent(j);
    return true;
}

static void runVeggieScan() {
    gState = STATE_VEGGIE_SCAN;
    gCancelRequested = false;
    resetSmoothing();
    sendEvent(String("{\"evt\":\"veggie_scanning\",\"purpose\":\"") +
              gPendingPurpose + "\"}");

    unsigned long t0 = millis();
    unsigned long lastInfer = 0;
    int   foundIdx  = -1;
    float foundConf = 0.0f;

    while (millis() - t0 < VEGGIE_LOCAL_TIMEOUT_MS) {
        if (gCancelRequested) {
            Serial.println("[veggie] cancelled");
            sendEvent("{\"evt\":\"veggie_cancelled\"}");
            gState = STATE_IDLE;
            return;
        }
        if (millis() - lastInfer < INFERENCE_INTERVAL_MS) { delay(10); continue; }
        lastInfer = millis();

        int idx; float conf; bool locked;
        if (!classifyOnce(idx, conf, locked)) continue;
        Serial.printf("[veggie] %s%s %.2f\n",
                      locked ? "LOCK " : "...  ", LABELS[idx], conf);
        if (locked) { foundIdx = idx; foundConf = conf; break; }
    }

    if (foundIdx >= 0) {
        String j = "{";
        j += "\"evt\":\"veggie_result\",";
        j += "\"label\":\""; j += LABELS[foundIdx]; j += "\",";
        j += "\"confidence\":"; j += String(foundConf, 3); j += ",";
        j += "\"purpose\":\""; j += gPendingPurpose; j += "\"";
        j += "}";
        sendEvent(j);
    } else if (!gCancelRequested && runCloudProduceFallback(gPendingPurpose)) {
        // veggie_result already sent by the fallback.
    } else {
        sendEvent(String("{\"evt\":\"veggie_unknown\",\"purpose\":\"") +
                  gPendingPurpose + "\"}");
    }
    gState = STATE_IDLE;
}

// Captures one UXGA JPEG at the given quality into a fresh PSRAM buffer (the
// caller frees it with heap_caps_free). Returns nullptr on failure with outLen
// untouched. Up-shifts the sensor to UXGA, drains stale frames, copies the
// frame out, then restores QVGA q10 for veggie streaming. The buffer was sized
// at init for CAPTURE_JPEG_QUALITY, so any quality >= that is overflow-safe.
// Also caches the JPEG for the debug preview server.
static uint8_t* captureJpegUXGA(int jpegQuality, size_t& outLen) {
    outLen = 0;
    sensor_t* s = esp_camera_sensor_get();
    if (!s) return nullptr;

    s->set_framesize(s, FRAMESIZE_UXGA);
    s->set_quality(s, jpegQuality);
    drainCameraFrames(3);

    camera_fb_t* fb = esp_camera_fb_get();
    uint8_t* jbuf = nullptr;
    if (fb) {
        Serial.printf("[capture] UXGA q%d -> %ux%u %u bytes\n",
                      jpegQuality, (unsigned)fb->width, (unsigned)fb->height,
                      (unsigned)fb->len);
        jbuf = (uint8_t*)heap_caps_malloc(fb->len, MALLOC_CAP_SPIRAM);
        if (jbuf) {
            memcpy(jbuf, fb->buf, fb->len);
            outLen = fb->len;
            debugStoreReceiptJpeg(jbuf, fb->len);   // browser preview
        }
        esp_camera_fb_return(fb);
    }

    // Restore sensor for veggie streaming.
    s->set_framesize(s, FRAMESIZE_QVGA);
    s->set_quality(s, 10);
    drainCameraFrames(2);

    return jbuf;
}

// One-shot receipt flow: capture UXGA → upload to /receipts/analyze →
// stream the OCR JSON result back on the data characteristic.
static void runReceiptCapture() {
    gState = STATE_RECEIPT_CAPTURE;
    sendEvent("{\"evt\":\"receipt_capturing\"}");

    // Max fidelity for OCR; buffer is sized for CAPTURE_JPEG_QUALITY at init.
    size_t   jlen = 0;
    uint8_t* jbuf = captureJpegUXGA(CAPTURE_JPEG_QUALITY, jlen);
    if (!jbuf) {
        sendEvent("{\"evt\":\"receipt_error\",\"code\":\"capture\",\"msg\":\"capture failed\"}");
        gState = STATE_IDLE; return;
    }

    gState = STATE_RECEIPT_UPLOAD;
    sendEvent("{\"evt\":\"receipt_uploading\"}");

    String errCode, errMsg;
    String resp = uploadReceipt(jbuf, jlen, errCode, errMsg);
    heap_caps_free(jbuf);
    parkEspnow();   // back to the display's channel before any ESP-NOW send

    if (resp.length() == 0) {
        String j = "{\"evt\":\"receipt_error\",\"code\":\"";
        j += errCode; j += "\",\"msg\":\"";
        for (size_t i = 0; i < errMsg.length() && i < 200; i++) {
            char c = errMsg[i];
            if (c == '"' || c == '\\' || c == '\n' || c == '\r') c = ' ';
            j += c;
        }
        j += "\"}";
        sendEvent(j);
        gState = STATE_IDLE; return;
    }

    // Heavy WiFi/TLS just finished; give the radio a generous moment to
    // settle before we start pushing ESP-NOW frames. Without this, the first
    // frames after upload are silently dropped.
    delay(500);

    // DEBUG: stream the first 10 items as individual single-frame events.
    // Small payloads, no chunked reassembler — easiest path to verify items
    // are arriving on the display.
    int n = sendReceiptTestStream(resp, 10);
    Serial.printf("[receipt_test] streamed %d items\n", n);
    gState = STATE_IDLE;
}

static void runRecipe() {
    gState = STATE_RECIPE;
    String recipe = buildRecipeMock(gPendingIngredientsJson);
    sendEvent("{\"evt\":\"recipe_result\"}");
    sendData(recipe);
    gState = STATE_IDLE;
}

static void handleCmd(const String& cmd) {
    String name = extractStringField(cmd, "cmd");
    if (gState != STATE_IDLE && name != "cancel") {
        Serial.printf("[cmd] busy, dropping %s\n", name.c_str());
        sendEvent("{\"evt\":\"error\",\"code\":\"busy\",\"msg\":\"already running\"}");
        return;
    }

    if (name == "start_veggie_scan") {
        gPendingPurpose = extractStringField(cmd, "purpose");
        if (gPendingPurpose.length() == 0) gPendingPurpose = "in";
        runVeggieScan();
    } else if (name == "capture_receipt") {
        runReceiptCapture();
    } else if (name == "get_recipe") {
        // Legacy mock path; not used by the new UI flow.
        gPendingIngredientsJson = extractArrayField(cmd, "ingredients");
        runRecipe();
    } else if (name == "get_recipe_list") {
        gPendingTrigger         = extractStringField(cmd, "trigger");
        gPendingIngredientsJson = extractArrayField(cmd, "ingredients");
        runRecipeList();
    } else if (name == "get_recipe_steps") {
        gPendingDish            = extractStringField(cmd, "dish");
        gPendingIngredientsJson = extractArrayField(cmd, "ingredients");
        runRecipeSteps();
    } else {
        Serial.printf("[cmd] unknown: %s\n", name.c_str());
    }
}

// ============================================================================
//                              setup() / loop()
// ============================================================================

void setup() {
    Serial.begin(115200);
    delay(400);
    Serial.println("\n=== SnapChef Main ===");

    if (!psramFound()) {
        Serial.println("FATAL: PSRAM required (enable 'OPI PSRAM').");
        while (true) delay(1000);
    }

    pinMode(TRIG_PIN, OUTPUT);
    pinMode(ECHO_PIN, INPUT);
    digitalWrite(TRIG_PIN, LOW);

    if (!initCamera()) { Serial.println("FATAL: camera init failed"); while (true) delay(1000); }
    Serial.println("camera OK");

    if (!initModel())  { Serial.println("FATAL: model init failed");  while (true) delay(1000); }
    Serial.printf("model OK, unknown_class_idx=%d\n", unknown_class_idx);

    connectWiFi();
    if (WiFi.status() == WL_CONNECTED) {
        // NTP (UTC) so we can relay wall-clock time to the clock-less display.
        configTime(0, 0, "pool.ntp.org", "time.nist.gov");
        healthzSelfCheck();
        initDebugServer();
        // Wait briefly for NTP so the first inventory items get a real time.
        for (int i = 0; i < 20 && time(nullptr) < 1700000000; i++) delay(250);
        Serial.printf("[time] epoch=%ld\n", (long)time(nullptr));
    }

    initEspNow();
    // Release the AP association and start sweeping channels for the display;
    // loop() hops until its HELLO arrives, then we lock (see onEspNowRecv).
    WiFi.disconnect(false);
    delay(30);
    gCurChan = kEspnowHopChans[0];
    esp_wifi_set_channel(gCurChan, WIFI_SECOND_CHAN_NONE);
    Serial.println("[espnow] scanning channels 1/6/11 for the display...");
    Serial.println("ready");
}

void loop() {
    // 0. Service the debug preview HTTP server.
    if (WiFi.status() == WL_CONNECTED) gDebugServer.handleClient();

    // 0b. Until the display links, sweep ESP-NOW channels to find whichever one
    // it chose at boot. Stops automatically once linked (gPeerLinked).
    if (!gPeerLinked && millis() - gLastHopMs > 400) {
        gLastHopMs = millis();
        gCurChan = kEspnowHopChans[gHopIdx];
        gHopIdx = (gHopIdx + 1) % (sizeof(kEspnowHopChans) / sizeof(kEspnowHopChans[0]));
        esp_wifi_set_channel(gCurChan, WIFI_SECOND_CHAN_NONE);
    }

    // 1. Pull pending command (filled by the ESP-NOW recv callback).
    if (gCmdPending) {
        String c = gPendingCmd;
        gCmdPending = false;
        handleCmd(c);
    }

    // 1b. Relay wall-clock to the display: right after a peer links, then
    // periodically so its drift-free clock stays close to ours.
    static unsigned long lastTimeSync = 0;
    if (gPeerJustLinked) {
        gPeerJustLinked = false;
        sendTimeSync();
        lastTimeSync = millis();
    } else if (gState == STATE_IDLE && millis() - lastTimeSync > 600000UL) {
        lastTimeSync = millis();
        sendTimeSync();
    }

    // 2. HC-SR04 proximity wake (only when idle and a peer is connected).
    static unsigned long lastProx = 0;
    static unsigned long lastWake = 0;
    if (millis() - lastProx >= PROXIMITY_INTERVAL_MS) {
        lastProx = millis();
        if (gState == STATE_IDLE && gPeerLinked) {
            float d = readDistanceCm();
            if (d > 0 && d < DETECT_CM &&
                millis() - lastWake > PROXIMITY_COOLDOWN_MS) {
                lastWake = millis();
                Serial.printf("[proximity] %.1f cm — wake\n", d);
                sendEvent("{\"evt\":\"proximity_wake\"}");
            }
        }
    }

    delay(10);
}
