IrisYzh/SnapChef/(commit log)

2026-04-21 Add vela compile
    [veggie_mnv2_sensecraft_int8_summary_Grove_Vision_AI_V2.csv]
2026-05-09 Add UI, milestone, Ideation PDF; remove .DS_Store tracking; ignore videos
    [code-format.cfg, partitions.csv]
